kaikino/dance-trainer/README.md

# Dance Trainer

```
firmware/   ankle node
app/        Android app
ml/         for model + training to replace classifier
presets/    choreography files
docs/
hardware/
```
