kaikino/dance-trainer/app/assets/music/README.txt

Drop music files here and reference them from a preset with "music": "<file>".
Without one, the app generates a metronome track for the preset.
