kaikino/dance-trainer/(commit log)

2026-10-30 Plan: step classification is the current design; reference-motion judging parked as future direction
2026-10-30 firmware: IMU serial stream example and live plotter (work in progress)
2026-11-03 IMU power pin needs nRF52 high-drive mode; imu_stream example verified on hardware
2026-11-03 Calibration learns the toe direction from a slide-forward gesture; all nine window channels are mount-independent; right foot mirrored consistently; rotation augmentation in training
2026-11-03 Slide-forward detection on velocity, verified on hardware
2026-11-04 Step chart draws arrows; beat clock compensates for audio output delay
    The chart and the nodes' t0 followed just_audio's position, which starts
    counting at play() while Android plays the first sound 100-300 ms later,
    so the steps ran ahead of the music. The clock is now the wall clock from
    play() minus a per-device sound delay, measured once with a tap-along test
    (Routine screen, Sound sync) and saved in settings.json. The chart redraws
    every frame instead of on coarse position updates. Music now plays at the
    tempo slider's speed, and the metronome cache key includes the exact bpm.
2026-11-04 Motor SIG on D9 (P1.14), NC wire on D10; add a pin-sweep motor test sketch
2026-11-04 Live view: 3D shoe that follows each calibrated node, plus side and rear tilt views
    Opens from the node card and right after Calibrate. The shoe is the
    idle-mode Stream quaternion (calibrated foot frame to world) with the
    heading zeroed on Set straight ahead; the floor arrow is the foot-frame
    acceleration. Status gains cal_flags (still pose / slide gesture done) so
    the app can say whether a node is calibrated; 6-byte Status from older
    firmware still parses. Fake nodes sway and slide so the view works on the
    emulator.
2026-11-04 Guided calibration: real stillness, three agreeing slides, honest failures, moved-strap warning
    Firmware 0.3. Calibration runs in its own task and reports its phase in
    Status (now 10 bytes), so the app can say what to do next instead of waiting
    a fixed 9 s behind a buzz. It starts by itself after 1.5 s of real stillness,
    takes three slides that must agree within 15 degrees, and can be cancelled. A
    failed slide now leaves the node tilt-only; it used to keep the old direction
    and report calibrated. A cal flag warns when gravity no longer matches the
    calibration while still. The app gains a guided Calibrate screen, Calibrate
    both feet (one foot after the other), and a warning on the Routine scr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
    [app.cpp, ble.cpp, board.h, dt_protocol.h, fusion.c, fusion.h]
2026-11-04 ble-protocol: calibrate runs in the background, add cal_cancel
2026-11-06 Live view: one simple view, foot pushed off centre by acceleration
    Replaces the shoe model and the side and rear views with a single flat
    foot-shaped sole seen from behind, lifted over its floor shadow. It turns
    and tilts with the foot and moves off the centre mark the way the foot
    accelerates, instead of drawing a velocity arrow.
2026-11-06 Live view: offset the foot by its velocity, not its acceleration
    Velocity is integrated from the floor-plane acceleration at 50 Hz, leaks
    back to zero over about 0.6 s and resets after 100 ms of stillness, so
    drift cannot leave the foot stranded off centre. 1 m/s reaches the ring.
2026-11-06 Live view: steadier velocity offset, floor grid instead of the ring
    Velocity no longer snaps to zero mid-slide: the foot only counts as still
    after 0.2 s of small horizontal and vertical acceleration and small
    rotation. Every sample is integrated on arrival with node timestamps
    (the display queue used to drop samples), acceleration bias is learned
    while still, the leak is gentler (1.5 s) and the drawn offset eases.
    A fixed floor grid replaces the ring.
2026-11-06 Live view: spring push from acceleration instead of a velocity estimate
    The foot is a mass on a critically damped 1.5 Hz spring driven by the
    bias-corrected floor-plane acceleration (0.03 g dead band). It leans the
    way it is pushed and settles back on its own, so nothing integrates
    without bound. Offset is softly limited to 0.4 foot lengths.
2026-11-06 Danceable routines and a side_in (close) step class
    The box step could not be danced: each loop left the left foot a step
    further forward and to the left, and there was no way to step inward
    without crossing. Adds class 7 side_in (close up beside the other foot)
    across firmware, app, ML and docs; the rules split inward steps into
    side_in and cross by distance (threshold from synthetic data). Replaces
    the box step with Basic forward and back and Side to side, keeps
    grapevine (already danceable), and adds an optional length_beats so a
    loop can end on a rest. app/test/preset_test.dart checks every preset
    for weight and for feet returning each loop. CNN retrained on synthetic
    data with 8 outputs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
    [dt_protocol.h, rules.c]
